DSchroer/AlarmClock/v1/docs/pinout.md

## The main controller pinout

1   LCD PIN
2   LCD PIN
3   LCD PIN
4   LCD PIN
5   LCD PIN
6   MOSI (orange)
7   MISO (brown)
8   SCK (red)
9   RESET (green)
10  VCC (white)
11  GND (black)
12
13
14
15
16
17  LCD PIN (R/W)
18  BUZZER              23  CLOCK (RX/TX)
19                      22  CLOCK (RX/TX)
20  LCD PIN  RS           21  BUTTON
