DSchroer/AlarmClock/v2/case/case.FCStd

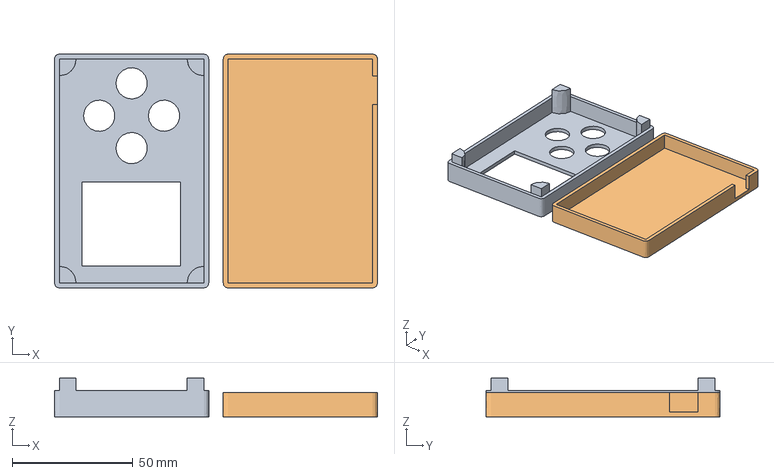
[picture p1: CAD file, 2019-11-30]
v2/case/case.FCStd
134.0 x 97.0 x 16.0 mm
Top (Meshed)
Bottom (Meshed)
