DSchroer/AlarmClock/v2/design/Alarm2.kicad_pcb

## KiCad design v2/design/Alarm2.kicad_pcb (2020-05-17)

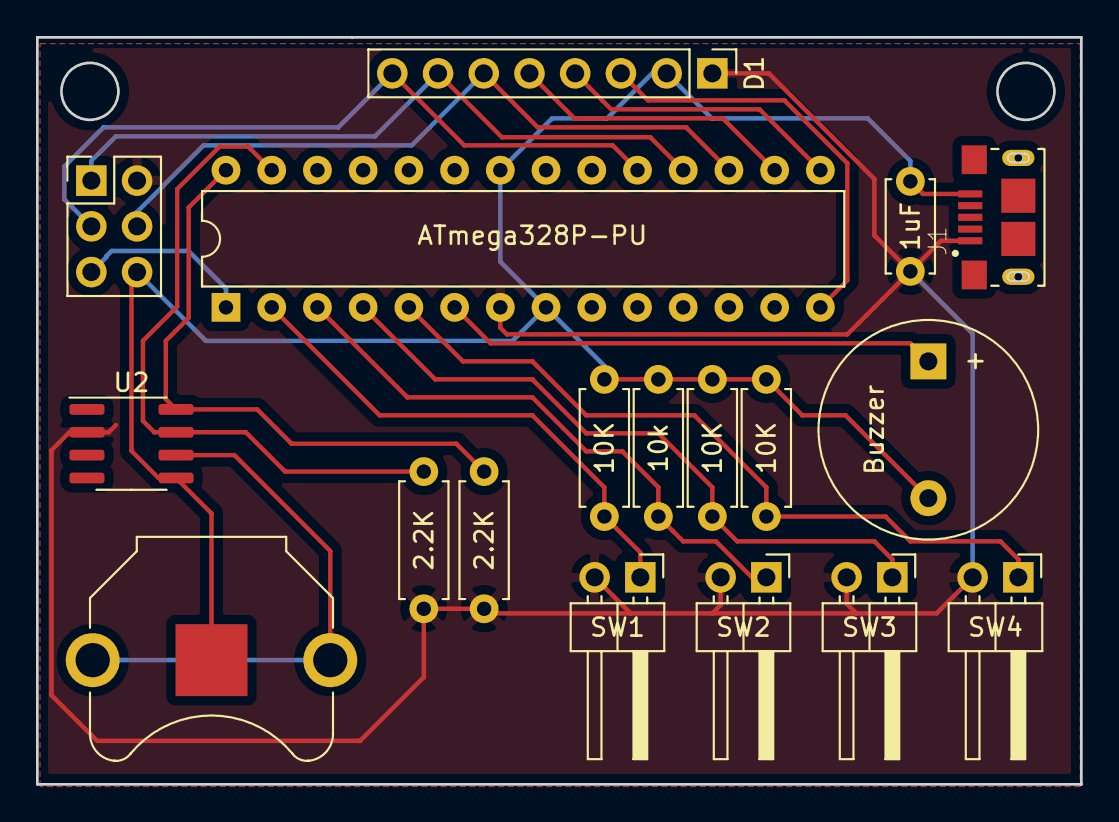
[picture p2: board Alarm2.kicad_pcb from above]

Board: 2 copper layers, 58.0 x 41.5 mm, 18 parts (0 on the bottom side), 15 nets.

Parts:
BT1: Battery_Cell; BatteryHolder_Keystone_3001_1x12mm
BZ1: Buzzer; Buzzer_12x9.5RM7.6
C1: 1uF; C_Disc_D5.0mm_W2.5mm_P5.00mm
D1: Nokia-5110; PinHeader_1x08_P2.54mm_Vertical
J1: 10118193-0001LF; FCI_10118193-0001LF
J2: AVR-ISP-6; PinHeader_2x03_P2.54mm_Vertical
R1, R3, R4: 10K; R_Axial_DIN0207_L6.3mm_D2.5mm_P7.62mm_Horizontal
R2: 10k; R_Axial_DIN0207_L6.3mm_D2.5mm_P7.62mm_Horizontal
R5, R6: 2.2K; R_Axial_DIN0207_L6.3mm_D2.5mm_P7.62mm_Horizontal
SW1, SW2, SW3, SW4: SW_Push; PinHeader_1x02_P2.54mm_Horizontal
U1: ATmega328P-PU; DIP-28_W7.62mm
U2: DS3231MZ; SOIC-8_3.9x4.9mm_P1.27mm

Connections:
unnamed: BT1.1, U2.6
unnamed: BT1.2, BZ1.2, C1.2, D1.2, J1.5, J2.6, R1.1, R2.1, R3.1, R4.1, U1.8, U1.22, U2.5
unnamed: BZ1.1, U1.6
unnamed: C1.1, D1.1, J1.1, J2.2, R5.1, R6.1, SW1.2, SW2.2, SW3.2, SW4.2, U1.7, U2.2
unnamed: J1.S1, J1.S2, J1.S3, J1.S4, J1.S5, J1.S6
unnamed: J2.1, U1.18
unnamed: J2.3, U1.19
unnamed: J2.4, U1.17
unnamed: J2.5, U1.1
unnamed: R1.2, SW1.1, U1.2
unnamed: R2.2, SW2.1, U1.3
unnamed: R3.2, SW3.1, U1.4
unnamed: R4.2, SW4.1, U1.5
unnamed: R5.2, U1.27, U2.7
unnamed: R6.2, U1.28, U2.8
