DSchroer/AlarmClock/v2/firmware/src/allocation.cpp

#include <stdlib.h>

#ifndef LOCAL
void *operator new(size_t size)
{
    return malloc(size);
}

void operator delete(void * ptr)
{
    free(ptr);
}

void *operator new[](size_t size)
{
    return malloc(size);
}

void operator delete[](void * ptr, unsigned int)
{
    free(ptr);
}

void operator delete[](void * ptr)
{
    free(ptr);
}
#endif
