DSchroer/AlarmClock/v2/firmware/src/utils/menu_manager.hpp

#pragma once
#include "../../drivers/include/display.hpp"
#include <drivers/buttons.hpp>

class Menu;

class MenuManager
{
private:
    Menu* current;
    Button& buttons;
public:
    MenuManager(Button& buttons): buttons{buttons} {};

    void MoveTo(Menu& menu);
    void Update();
    void Render(Display& display);
};

class Menu
{
protected:
    MenuManager& Manager;

public:
    Menu(MenuManager& manager): Manager{manager} {};

    virtual void Reset() {};
    virtual void Update() {};
    virtual void Render(Display& display) = 0;
    virtual void OnButton(uint8_t button) {};
};
