DSchroer/AlarmClock/v2/firmware/src/utils/light.cpp

#include "light.hpp"
#include "buttons.hpp"
#include "io.hpp"

#define LIGHT (1 << 5)

void init_light()
{
    DDRB |= LIGHT;
}

void update_light(Time &time)
{
    static uint8_t remaining = 0;
    static uint8_t seconds = 0;

    if (btn_any_pressed())
    {
        remaining = 10;
    }

    if (seconds != time.seconds)
    {
        seconds = time.seconds;

        if (remaining > 0)
            remaining--;
    }

    if (remaining > 0)
        set_light(true);
    else
        set_light(false);
}

void set_light(bool turnedOn)
{
    if (turnedOn)
        PORTB |= LIGHT;
    else
        PORTB &= ~LIGHT;
}
