DSchroer/AlarmClock/(commit log)

2019-04-08 Added new version files
    [Alarm2.kicad_pcb, Alarm2.sch, Alarm2_bom_1.csv]
2019-07-01 Added buttons support
2019-09-08 Added the beginning of the Alarm Edit Menu. Fixed deployment builds.
    [main.cpp, rtc.cpp, screen.cpp]
2019-11-30 Added case files
    [case.FCStd]
2020-03-20 Fixing memory issues with Vector
    [allocation.cpp, main.cpp]
2020-05-17 Added V2 PCB
    [Alarm2.kicad_pcb]
